royrobotiks/Graffomat/graffo_drawingprog_07/royrobotiks piece/1w.PNG

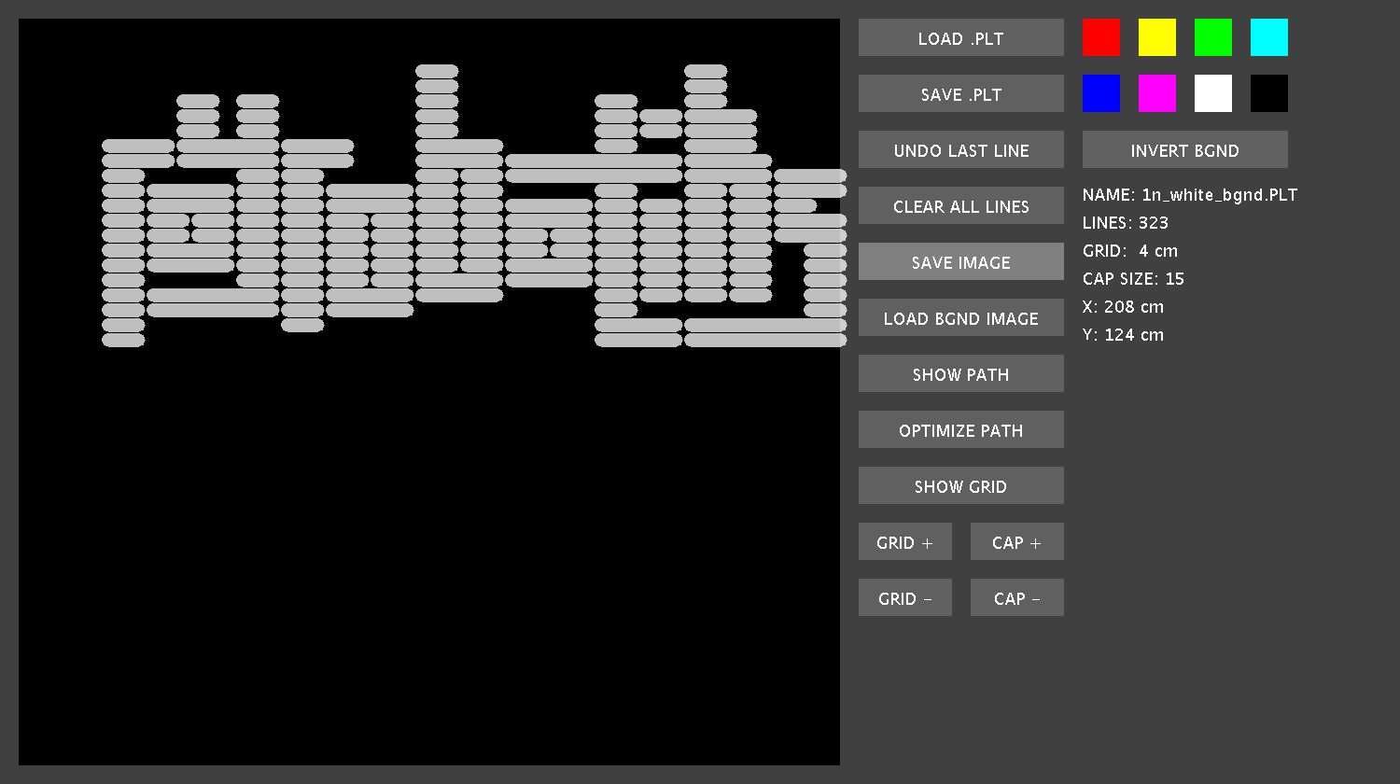
graffo_drawingprog_07/royrobotiks piece/1w.PNG
