royrobotiks/Graffomat/graffo_drawingprog_07/royrobotiks piece/4tb2.png

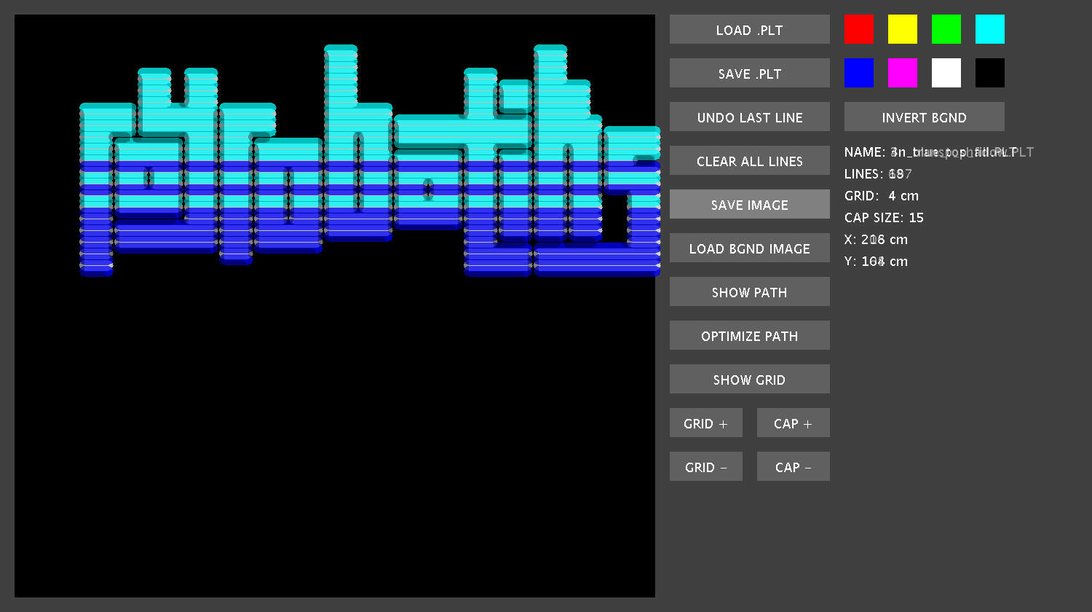
graffo_drawingprog_07/royrobotiks piece/4tb2.png
