royrobotiks/Graffomat/graffo_drawingprog_07/royrobotiks piece/6shadowPurple.PNG

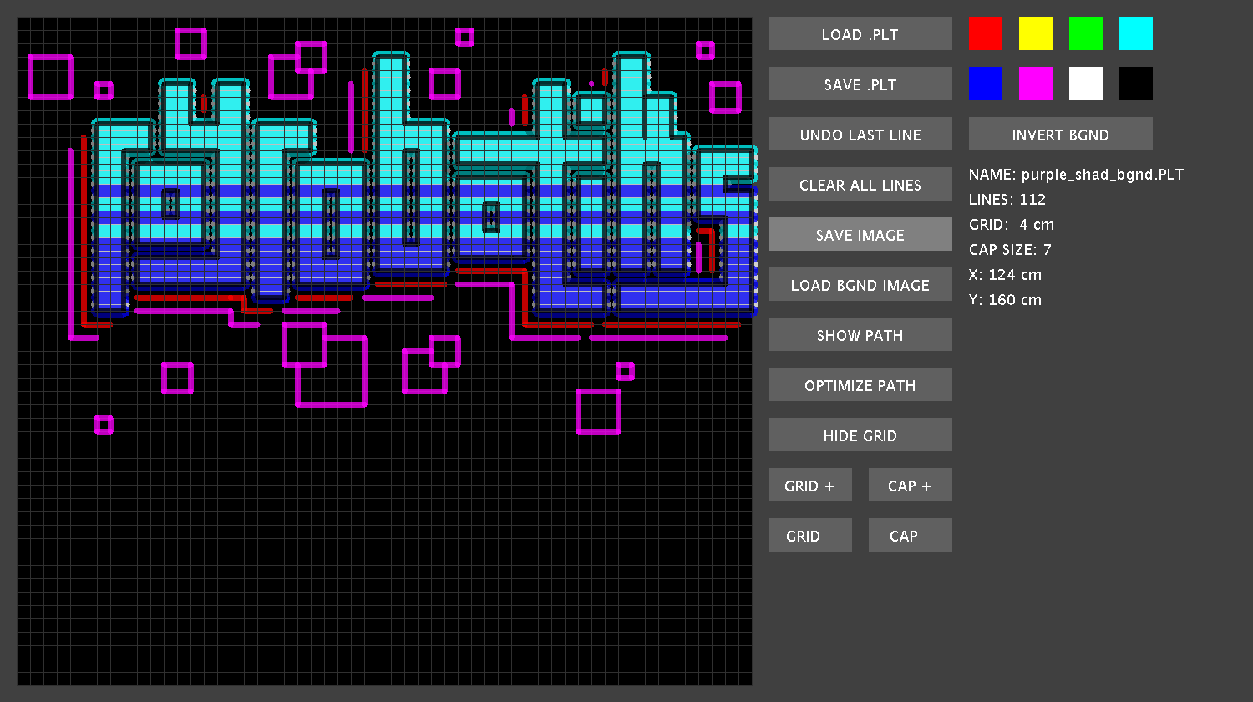
graffo_drawingprog_07/royrobotiks piece/6shadowPurple.PNG
