royrobotiks/Graffomat/graffo_drawingprog_07/royrobotiks piece/rrbgnd.PNG

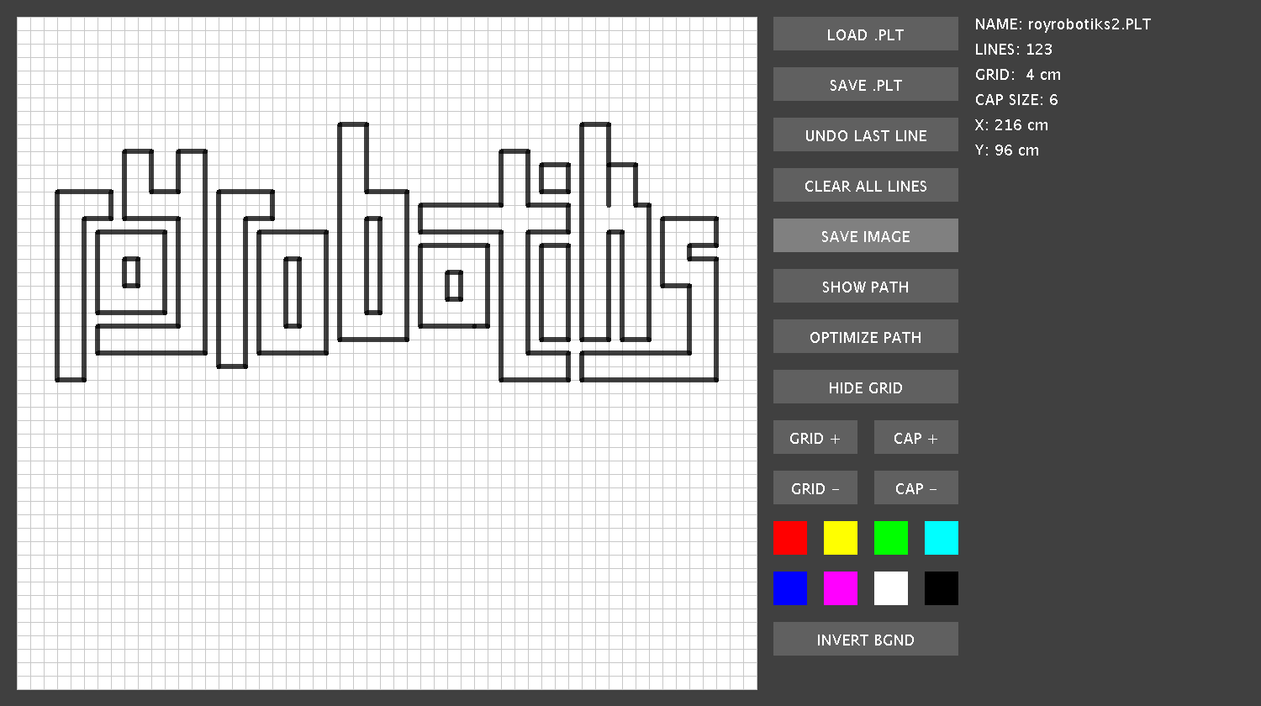
graffo_drawingprog_07/royrobotiks piece/rrbgnd.PNG
