royrobotiks/Graffomat/graffo_drawingprog_07/royrobotiks piece/shadow_red.PNG

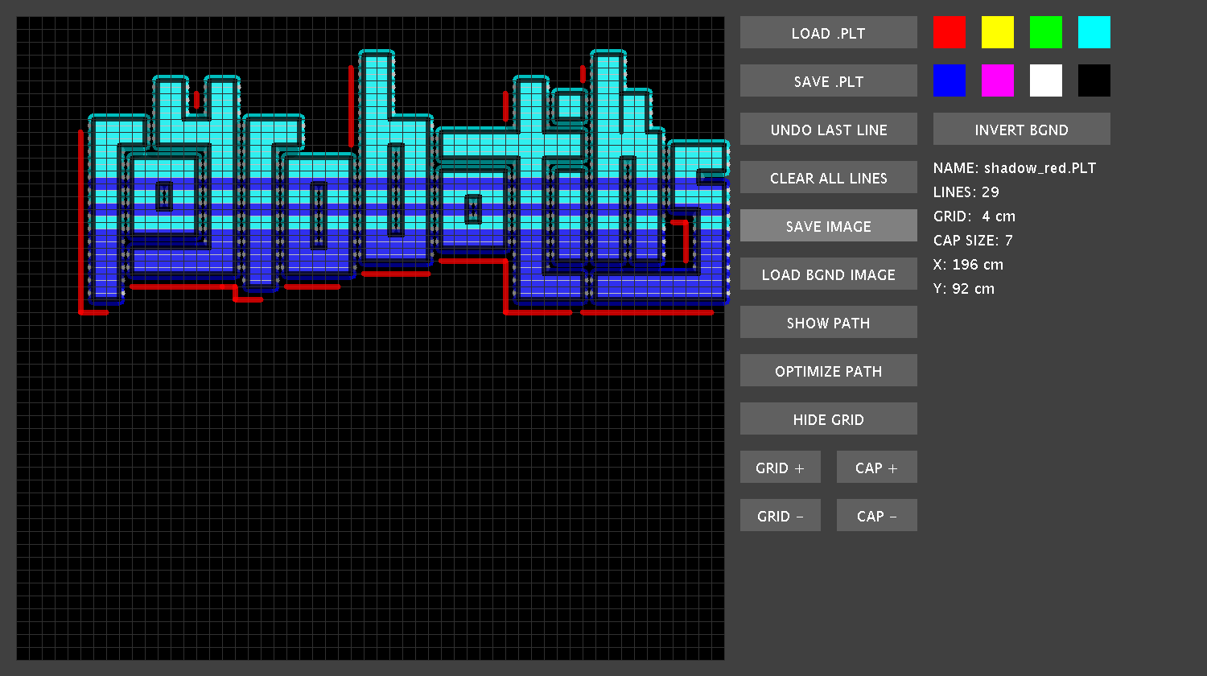
graffo_drawingprog_07/royrobotiks piece/shadow_red.PNG
