royrobotiks/Graffomat/plotter.jpg

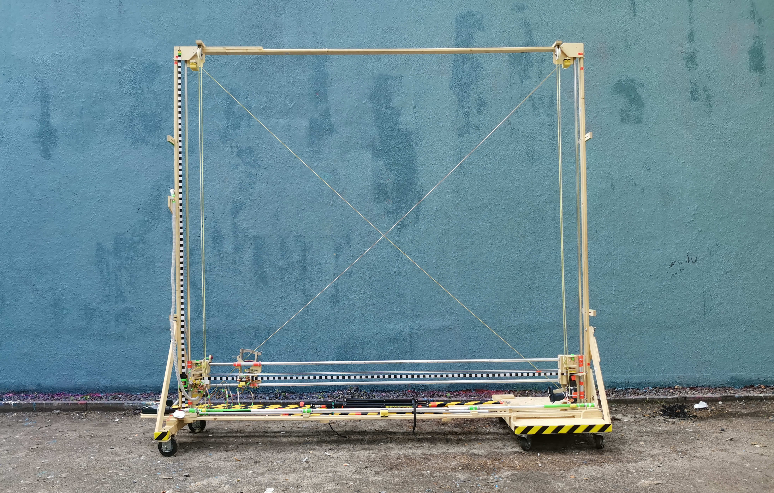
plotter.jpg
