royrobotiks/Graffomat/(commit log)

2021-09-21 Add files via upload
    Arduino Nano codes for the plotter driver
2021-09-21 SD Card reader w/ TFT screen - Arduino Code
2021-09-21 Add files via upload
    Plotter driver Arduino Nano code
2021-09-21 Plotter driver - Arduino code
2021-09-21 WebSocket ↔ Web Serial Interface - [ZIP: HTML, CSS, JS Codes]
